sunnybank101/BellTower/nodered/README.MD

FYI

If you run NodeRed on Rasbian you will need to manually install the following nodes
<ol>
  <li>https://flows.nodered.org/node/node-red-contrib-play-soundfile
</ol>

If you run NodeRed on windows you will ALSO need to manually install the following nodes
<ol>
  <li>https://flows.nodered.org/node/node-red-node-serialport
</ol>
