sunnybank101/BellTower/photos/README.MD

<H1>Photo Library</H1>

<p>Sensor preparation - sensors with short wires soldered to them and wrapped in clingfilm (to help reduce the impact of moisture on the electronics) ready for installation in the tower
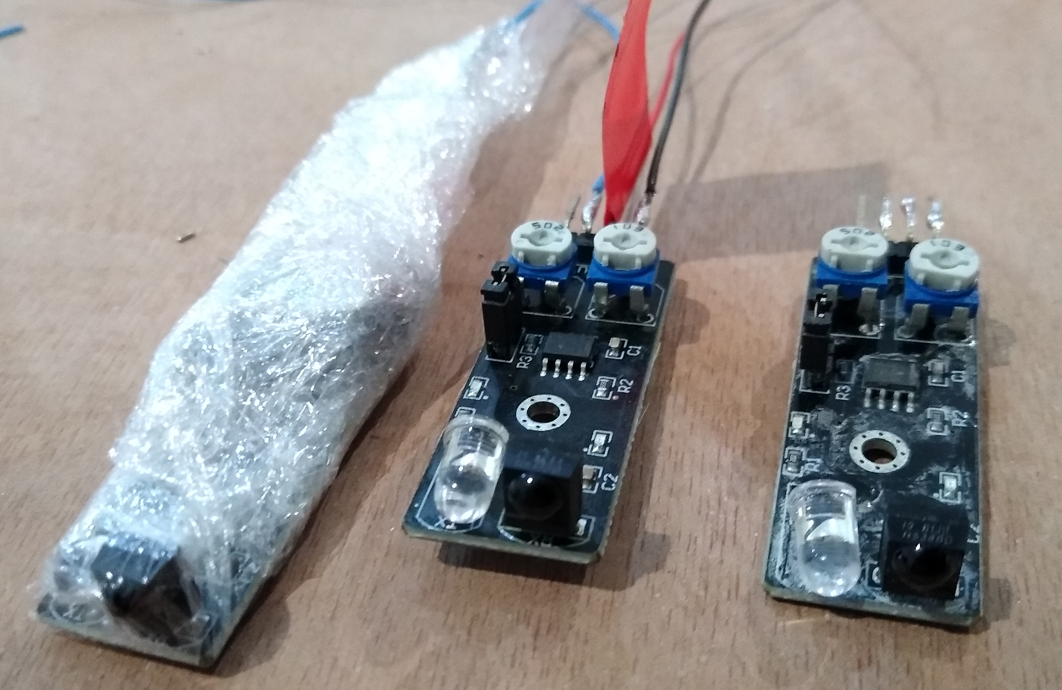
[picture p6: photos/sensorsprep.png]


<hr>
  
<p>Desk test setup
desk testing

<hr>
  
<p>Fitted sensors in the tower - this one point happens to be able to serve 2 bells which was very fortunate.  You can also see the white reflective tape on the bell wheels.
fitted sensors

<hr>
  
<p>Cables being installed - cables are tied to the underside of the top of the I beams so that you can still stand on any of the beams in those tight spots without fear of pulling wires.  The right hand side still needs tying in.
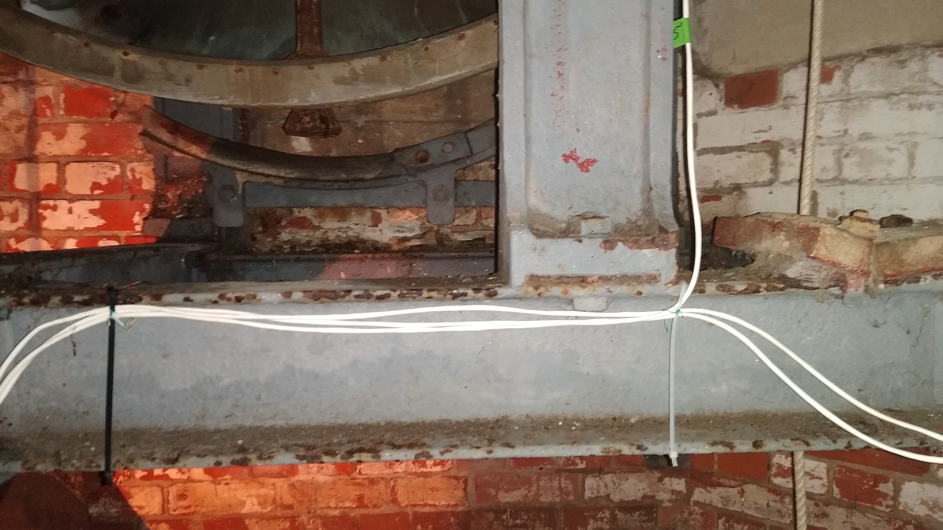
[picture p7: photos/wiring on frame.jpg]


<hr>

<p>
