sunnybank101/BellTower/Simulator info sheet.odt

Simulator Operations

ON

1. Turn on the simulator power
2. Wait for a few minutes to let it start up
3. Test by pulling a bell rope
4. Any problems wait a bit longer and try a bell again

OFF

1. Turn off the simulator power

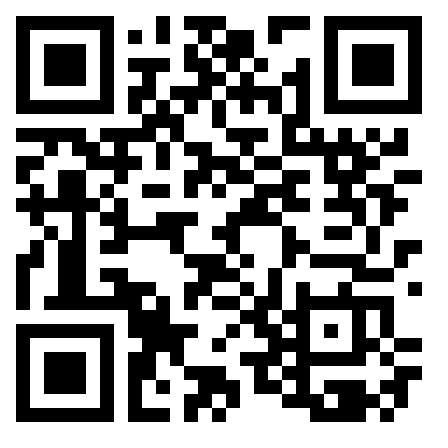
[picture p8: figure]
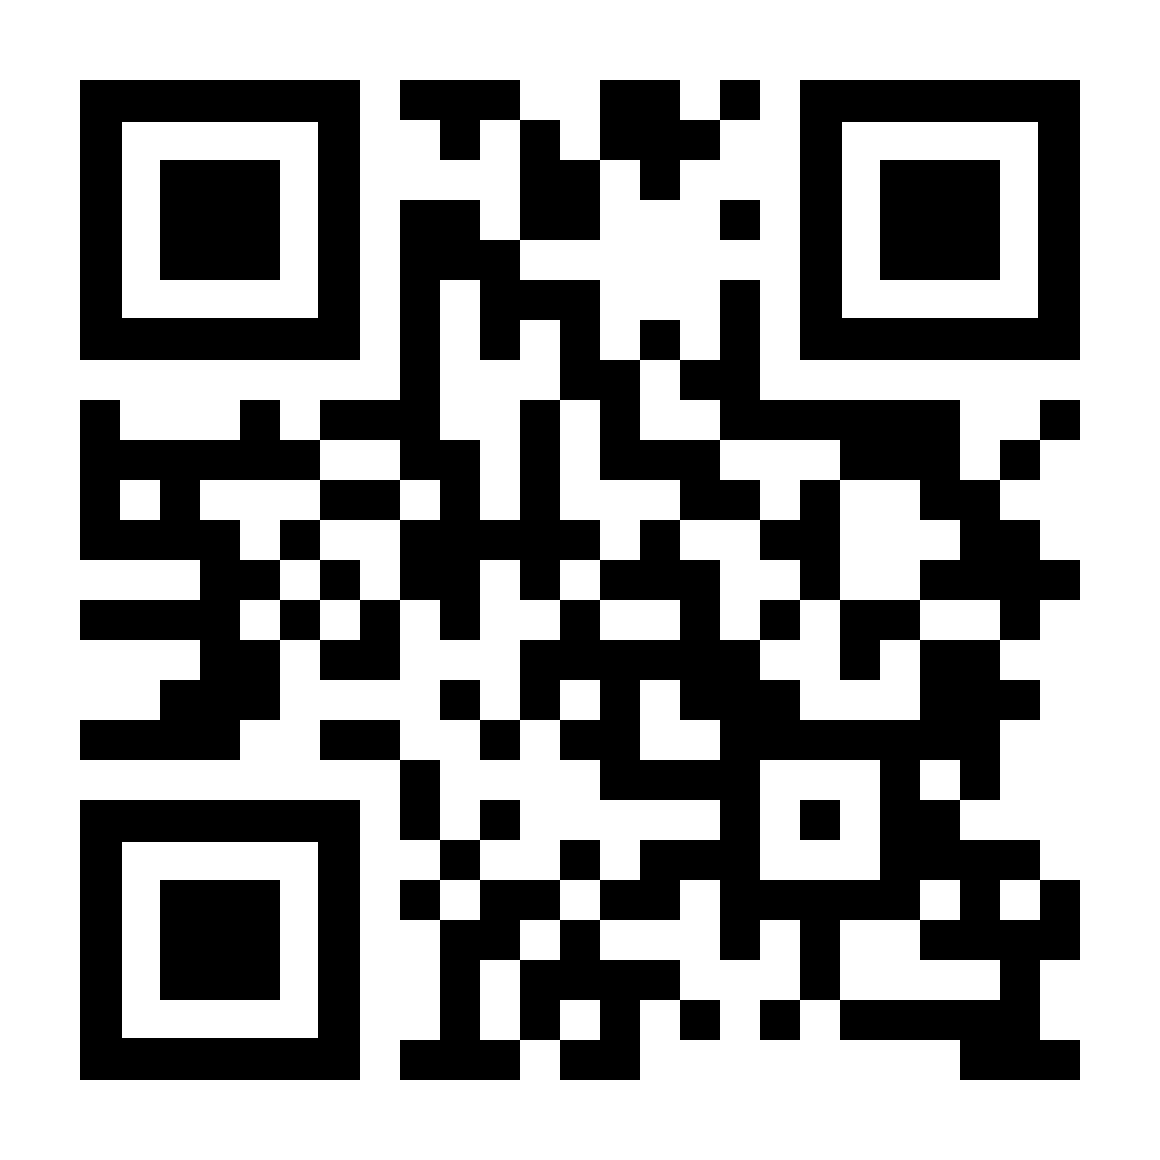
[picture p9: figure]

SIMULATOR WIFI | SIMULATOR WEB PAGE

Find out more about the simulator visit the GitHub webpage..

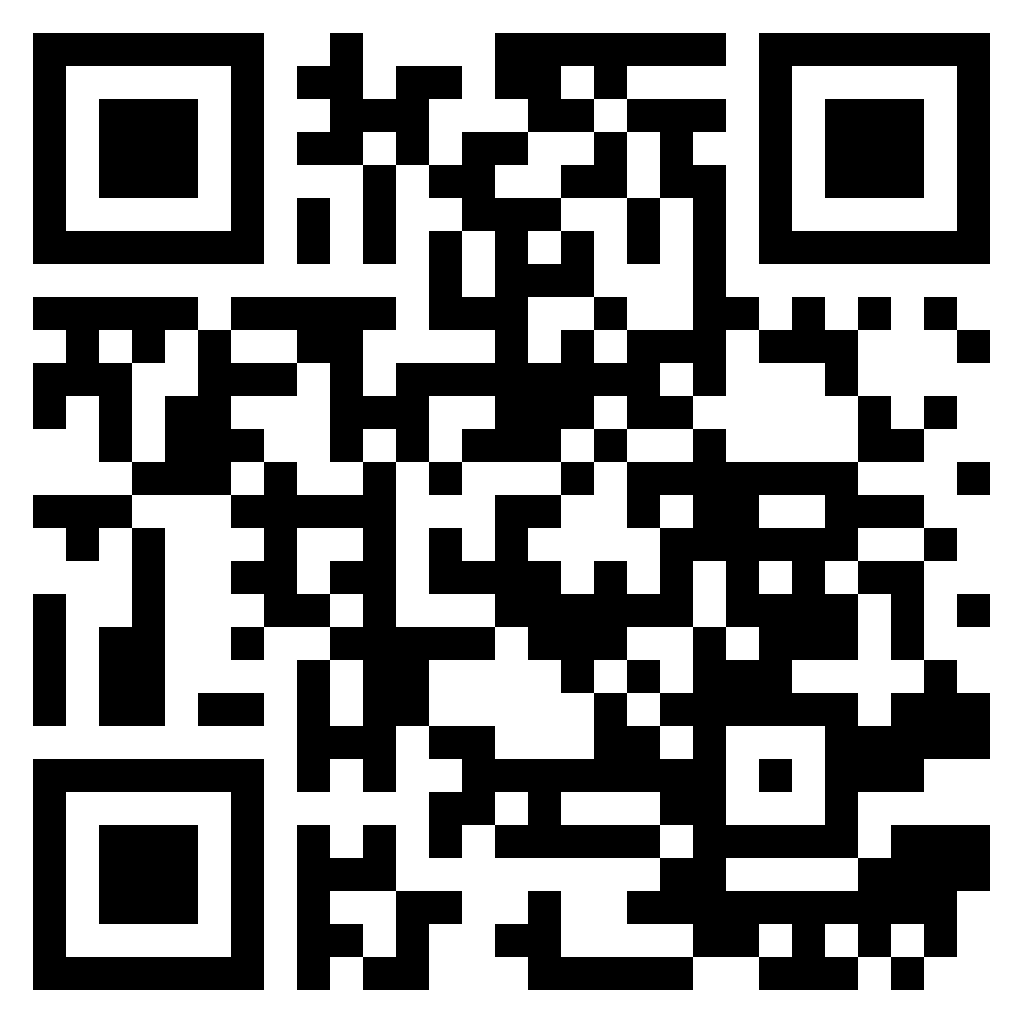
[picture p10: figure]
