sunnybank101/BellTower/(commit log)

2023-04-26 Add separate delays for handstroke and backstroke
    - delays are now configured as an array of backstroke and handstroke
    delays
    - save whether a bell is at handstroke when it rings
    - apply a different delay based on handstroke/backstroke
    - saw a potential issue where the delay was fetched after the bell
    adjustment was done - if you were using the front 6 bells, bell 1
    would be adjusted to ring bell 3, but the delay for bell 3 would be
    applied
    - added a button to the index screen to reset all the bells back to
    handstroke, sending this over the /ws/settings websocket.
    - altered the flow of the pc output serial port to send the message
    after the delay has happened so that all the dela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
2023-04-27 Update flow.json
    Improved config file reset and errors
    Added view bellconfig flow
2024-03-12 bell pins not initialised correctly
    [arduinoKY032.ino]
2024-03-12 hall effect sensor
    straight swap out of the IR sensor with the 3144E hall effect sensor
    [arduino3144E.ino]
